NegativeC/ducted-fan-pinewood-derby/(threads)

Thread 1 (2018-03-24):

EDF will not run at slow speed during staging

tboy555, 2018-03-24:
Hey Christian, I hope you get this, love the code and am planning on using it next week. I have it loaded into my trinket and working fine except for the staging speed.  Nothing happens there but the light turns on.  EDF runs to full power when the switch is released.  I tried a regular servo and got movement on it for two different positions.

Im guessing it is a calibration issue?  Any ideas?

NegativeC, 2018-03-24:
I think if you increase the STAGEDSPEED = 50 or so it’ll spin.  Also, you may need to read about your ESC on how to set the full throttle position.  Once it learns the max, it generates a linear curve from 0 to 100%.

tboy555, 2018-03-24:
Hey thanks for the reply. Really enjoying your code!  I’m not a programmer and so thanks to your help I’m able to do this!!

I think you are right, but late last night I tried another wax I had on hand rated for much less power. It worked as written!  I figure that I’ll be ok with races only being 2 seconds or less!

I will mess with the bigger speed control when I have more time. For now I’ll use the smaller one.

I think I will upload my edf mount to thingiverse once done, maybe it will help others.

Troy

Sent from my iPhone

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

NegativeC, 2018-03-24:
Cool, would like to see your mount.

Closed 2018-03-24.

Thread 2 (2019-01-06):

Circuit detail for beginners

Christopher-72, 2019-01-06:
Would be great to have more detail on how to wire up the ESC/IR/Trinket for beginners like me and my son.  Your sharing is valuable, thank you.

Christopher-72, 2023-01-22:
[https://postimg.cc/gallery/9RtWn0j](url)

Link to the gallery of a build using this code, a Trinket, and truly overkilling. 1.4 second race times.  Truly a masterpiece from Negative-C's code and inspiration.   Adjusted to 1.2 second thrust before shutoff.

- Adafruit Trinket M0
- Turnigy Graphene Panther 1400mAh 4S 75C Battery Pack w/XT60
- HobbyKing 80A ESC 4A SBEC
- Dr. Mad Thrust 70mm 11-Blade Alloy EDF 3900kv Motor - 1300watt (4S)

The hardest part was building a capture net to catch this missile at the end of the track.  The sound of the 7cm jet engine was amazing.

NegativeC, 2023-01-22:
Wow, I am extremely impressed with your build! Truly amazing work and that 70mm fan is huge! This makes me want to build a Version 2.0 😁
It would be interesting for someone with CFD experience to test different fan sizes and ducting for thrust optimization. I usually just go with what is lightest for acceleration.

NegativeC, 2023-01-22:
70mm should be 4 times the thrust of the 40mm fan 😲
It must sound great.

Christopher-72, 2023-01-27:
Honestly, without your work I wouldn’t have known where to have started.   I really valued your initial sharing.

In the process of building, my boys learned more about microcircuitry, fusion360, printing, soldering, and how you can make something fun.  Priceless – Thank you so much

-Christopher Powell

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

Christopher-72, 2023-01-28:
Since my build was screwed closed and included an insane amount of LiPo output and jet power.   I used a XTC connector as an external safety shunt to be able to pull the power from it while the scouts were looking at it.   The rear button was connected to reset, and the led of the button was used as the indicator.

Rejy3, 2024-01-27:
This is my first project with any sort of type of Arduino or sensors and like the original comment said, a circuit or more detailed explanation on how to wire everything together would be of great help. Thanks!

Thread 4 (2023-01-22):

LED?

TaterTot24, 2023-01-22:
Your idea and code are awesome . I am planning on doing very similar based on the information that you have here. However, the code references an LED on Pin#1, but It is not on the wiring diagram or referenced in the parts list or project overview. I didn't even see it in the pictures of the car either. I'm assuming from the code is to let you know whether or not the car is "armed" or not. Can you provide any more details?

NegativeC, 2023-01-22:
Pin 1 on the 5V trinket is an onboard LED.
https://www.adafruit.com/product/1501
You might be able to find them on DigiKey.

If you can only find the Pro Trinket version, then you can just use pin 13 instead of 1

TaterTot24, 2023-01-28:
So I am using the Trinket Pro 5V and I am getting an error with LINE 39 with "TIMSK" (."Compilation error: 'TIMSK' was not declared in this scope"). Apparently there is something different about the Trinket vs the Trinket Pro. I tried changing it to "TIMSK0" because I saw something on the SoftServo page about it. It will now compile, but I cannot get my motor to move (during STAGED or when RACING)

Christopher-72, 2023-01-28:
Trinket Pro is a Atmega328P chip while the Trinket is a Attiny85 - different processors.   I think you are correct that in the mega/uno is the TIMSK0 interrupt.  The signal interrupt is the same.   Check your wiring is correct and you have continuity and your ubec is getting power.  Validate your IR break beam and output pins are correct in the code.  I had to program my UBEC before my engine was set correctly -- if you haven't done that yet -- it may be your challenge. NegativeC has code for that as well if you don't have a programming card

And make sure you have the darn thing secured with a clamp or something when you are trying to get the code and circuit to work...  I had my 70mm jetcar launch when I was messing with it twice, until I built a harness to keep it from orbiting my workshop.    and please remember to shut off the engine early when testing...   I'd go 1100 milliseconds until you have it tested on a track...  mine was faster than 1500 milliseconds and you don't want it to continue to thrust past the finish line...  these things are crazy missiles.

NegativeC, 2023-01-28:
from the product description it seems like the IR input will have to be moved from pin 2 to pin 3 or something else.
Pins #2 and #7 are not available (they are exclusively for USB)
I think pin 0 is still okay for the ESC

TaterTot24, 2023-01-29:
I am looking at programing the ESC now (using NegativeC's other code). I am using Pin 3 for the ESC and Pin 5 for the IR (and Pin 13 for the LED as suggested earlier). Hopefully that is the issue. I will report back on what I find. Thanks guys!

TaterTot24, 2023-01-29:
So I found the problem. Apparently the Trinket Pro takes a couple of seconds to "boot up" and powering the Trinket Pro from the ESC is an issue, because it expects a usable "SERVO/THROTTLE" signal immediately (at lease my ESC does). When my ESC doesn't immediately see a signal, then it goes into some sort of protect mode. The way I figured this out is I had the Trinket Pro running off of USB power and once it "Boots Up", then I connect the LiPo and everything works like a champ. Anyone have any suggestions on how to make this work? Does the regular Trinket really boot that much faster? Do I need to try to find a regular Trinket?

NegativeC, 2023-01-29:
yeah, it seems to be the bootloader on the Pro.  It waits for 10 seconds before running the code which gives you a chance to upload a new program.
the code for that is here:
https://github.com/adafruit/Adafruit_ProTrinket_Bootloader
In main.c you could change the timeout from 10 to 1 but not sure it that will have undesired results. Adafruit has bootloader update instructions.  I wonder if you can just disable it entirely when there is no USB connection??

It might be best to buy a regular trinket (digikey) or maybe get a 5v regulator and boot it first before powering on the ESC

Thread 5 (2025-01-11):

trying to learn

danpark82, 2025-01-11:
amazing car and setup!  trying to learn and got a trinket m0.
will the ESC go through the initial setup of the low/high throttle each time you go to race?

NegativeC, 2025-02-05:
Not sure I know exactly what you mean but I'll try to answer.

There is an initial setup that is usually done on every ESC where it learns the 0-100 throttle range.  I only had to do this once and it remembers through power cycles.  I even have another program here that does this for you: https://github.com/NegativeC/HobbyKing_UBEC_programmer

Then each time the power is applied the car is "armed" and will go into the low/high throttle sequence for racing. Maybe I'll make another video showing this

Closed 2025-02-05.
