NegativeC/ducted-fan-pinewood-derby/media/car3.jpeg

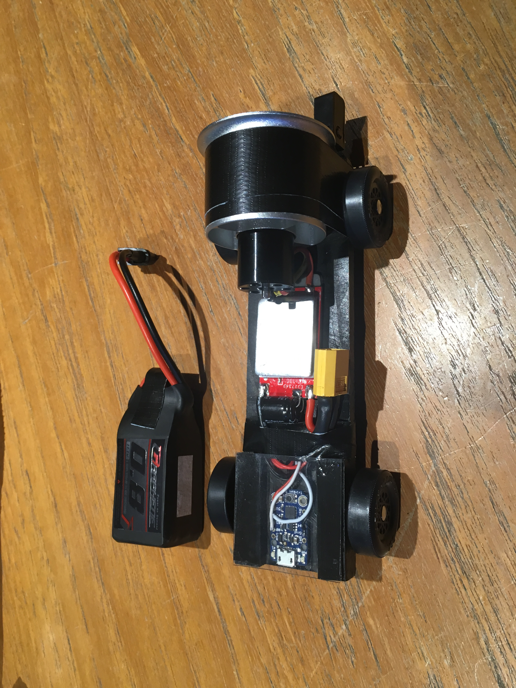
[picture p5: media/car3.jpeg]
media/car3.jpeg
