NegativeC/ducted-fan-pinewood-derby/media/car4.jpeg

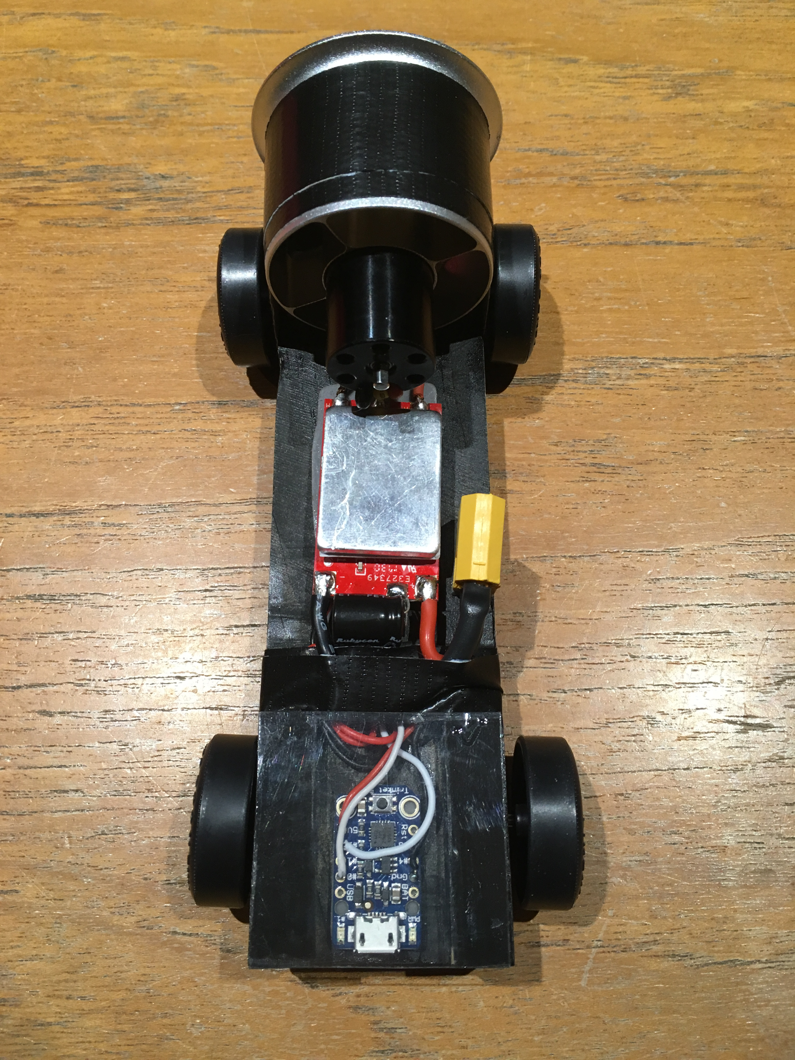
[picture p6: media/car4.jpeg]
media/car4.jpeg
